zoe-barbry/Projet-Arduino/Rapports de séance/ROUSSEAU Romain/Séance 4/Rapport de Séance 4.docx

Rapport de Séance 4 :

Cette séance, c’était le rapport de mi-projet.

J’ai donc commencé par monter ce qu’on avait fait jusqu’à présent.

Je me suis occupé du laser et de l’alarme quand Zoé s’est occupé des autres modules.

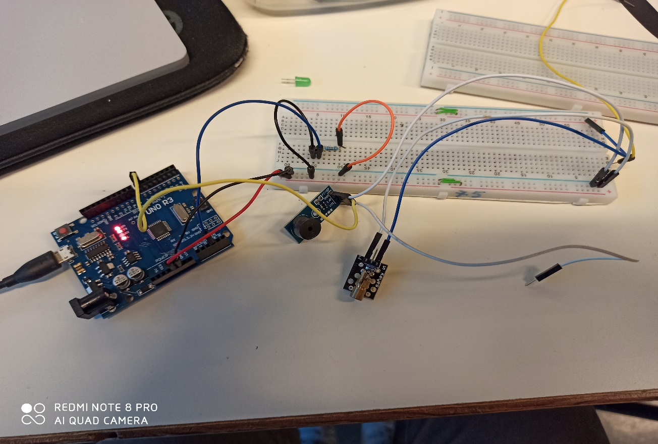
[picture p11: figure]

Photo du montage :

Pour des raisons de sécurité évidente, le laser n’est pas alimenté sur la photo.

Pour des raisons de confort évidente, l’alarme non plus.

Puis nous avons fait les tests.

A cause d’un problème de branchement, la photorésistance renvoyer toujours la valeur 1, le problème fut vite repéré et réparé.

Tout le reste marchait bien : l’alarme se déclenché quand le laser ne touchait pas la photorésistance, le pH-mètre, le thermomètre et le module de distance marchaient aussi bien que d’ordinaire.

Puis le rapport est arrivé. A cause d’un faux contact dû au fait que je ne branchais pas totalement le 5V de l’alarme, elle fût un peu capricieuse et sonna au début alors qu’elle ne devait pas, puis s’est mis à marchait comme prévu.

Le pH-mètre n’avait pas eu le temps de revenir à un pH neutre de 7, mais sa valeur a bien baissé quand on l’a plongé dans le jus de citron.

Après ça, nous avons récupérer les formats .stl de notre dossier OneShape (disponible sur github) pour les envoyer à Mr. Juan.

Enfin, pour préparer les prochaines séances, nous avons glaner des informations sur le module web d’arduino que nous utiliserons à Axel Delille, qui utilise lui aussi ce module.
