zoe-barbry/Projet-Arduino/Rapports de séance/ROUSSEAU Romain/Séance 4/Collecteur_de_donnees.stl

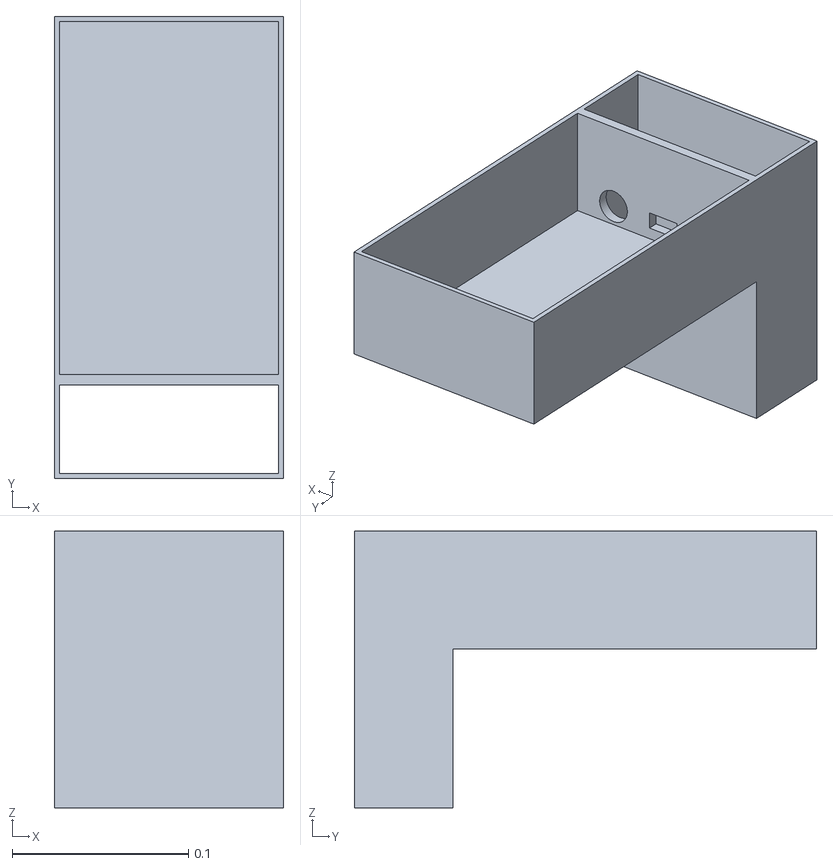
[picture p32: CAD file, 2022-01-12]
Rapports de séance/ROUSSEAU Romain/Séance 4/Collecteur_de_donnees.stl
0.13 x 0.262 x 0.157
