zoe-barbry/Projet-Arduino/Rapports de séance/ROUSSEAU Romain/Séance 4/Tour.stl

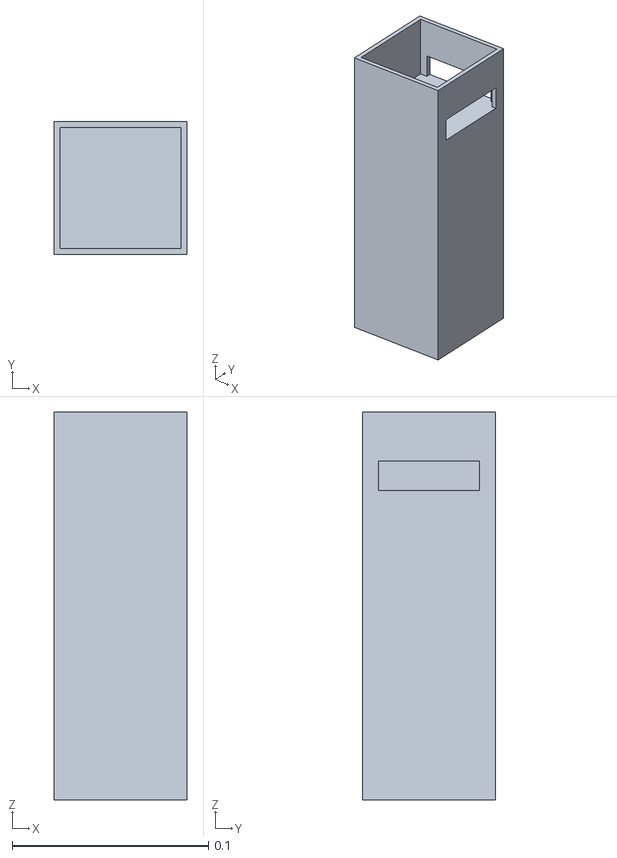
[picture p33: CAD file, 2022-01-12]
Rapports de séance/ROUSSEAU Romain/Séance 4/Tour.stl
0.0675 x 0.0675 x 0.198
