zoe-barbry/Projet-Arduino/Rapports de séance/ROUSSEAU Romain/Séance 4/Couvercle_laser.stl

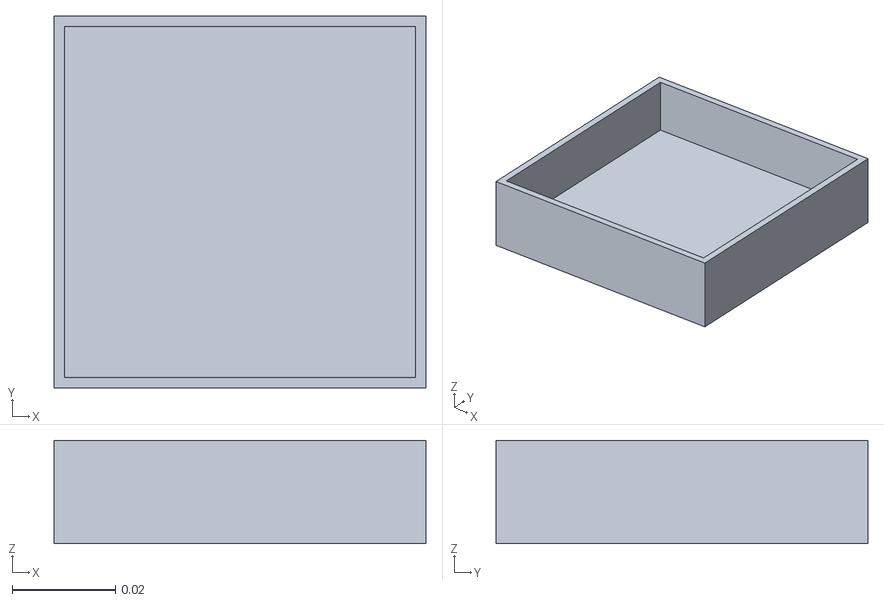
[picture p34: CAD file, 2022-01-12]
Rapports de séance/ROUSSEAU Romain/Séance 4/Couvercle_laser.stl
0.072 x 0.072 x 0.02
