zoe-barbry/Projet-Arduino/Rapports de séance/ROUSSEAU Romain/Séance 4/Couvercle_du_collecteur.stl

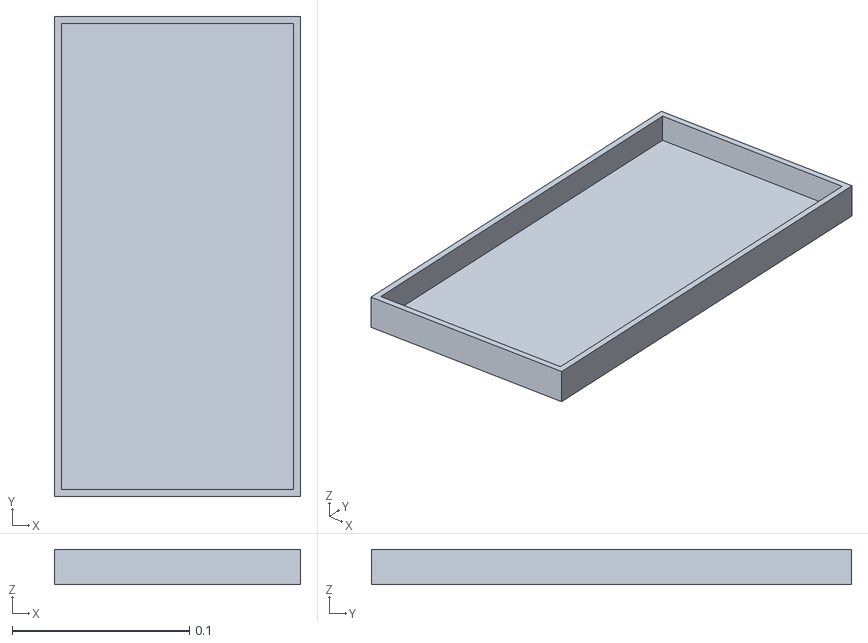
[picture p35: CAD file, 2022-01-12]
Rapports de séance/ROUSSEAU Romain/Séance 4/Couvercle_du_collecteur.stl
0.139 x 0.271 x 0.02
