zoe-barbry/Projet-Arduino/(commit log)

2021-12-02 Cahier des charge (pas relu pas complet)
2021-12-06 Create Cahier des charges
2021-12-07 Create Rapports de séance
2021-12-15 Create Code Laser
2022-02-04 Create Code Laser Test
2022-02-10 Create Laser DEbutFinal
2022-03-09 Create PowerPOint
